krisztian9913/elderCare/adatgyujtes/meresek/meres1_uveg_doles/dataAccelX.png

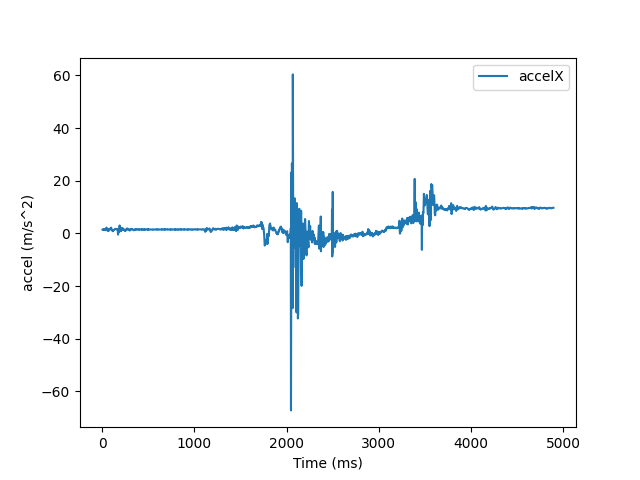
adatgyujtes/meresek/meres1_uveg_doles/dataAccelX.png
