krisztian9913/elderCare/adatgyujtes/meresek/meres1_uveg_doles/dataAccelY.png

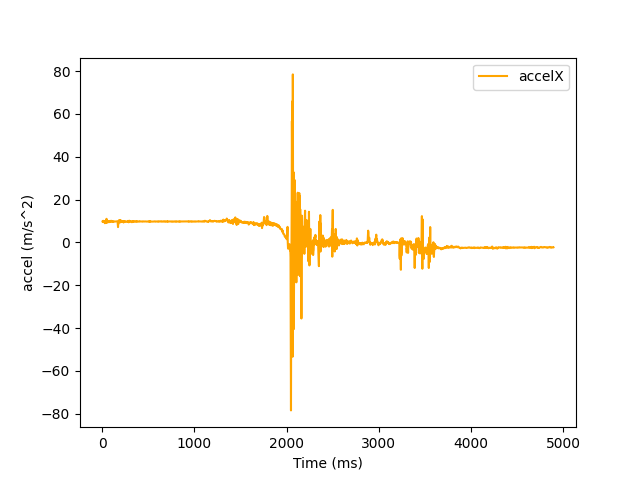
adatgyujtes/meresek/meres1_uveg_doles/dataAccelY.png
