krisztian9913/elderCare/adatgyujtes/meresek/meres1_uveg_doles/datamerged.png

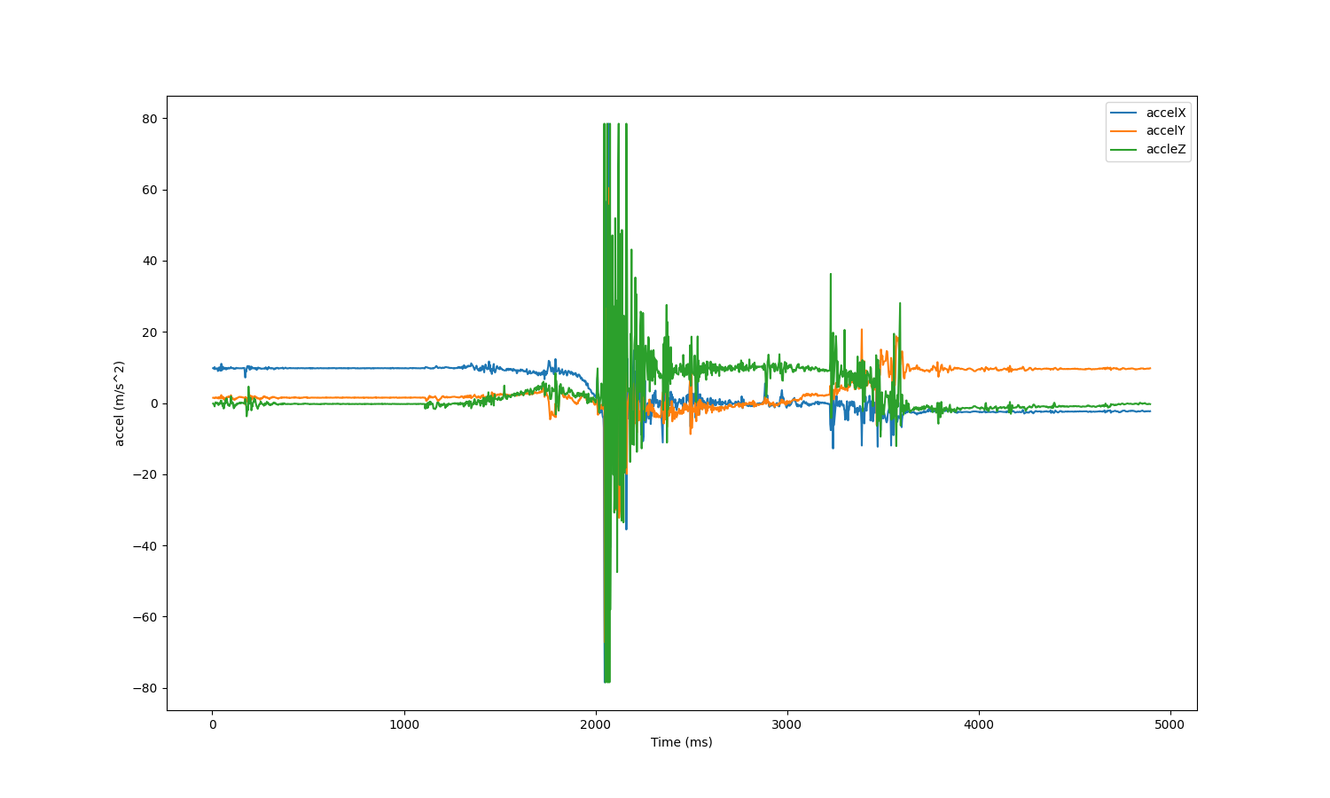
adatgyujtes/meresek/meres1_uveg_doles/datamerged.png
