krisztian9913/elderCare/adatgyujtes/meresek/meres2_allas_egyhelyben/data(7)merged.png

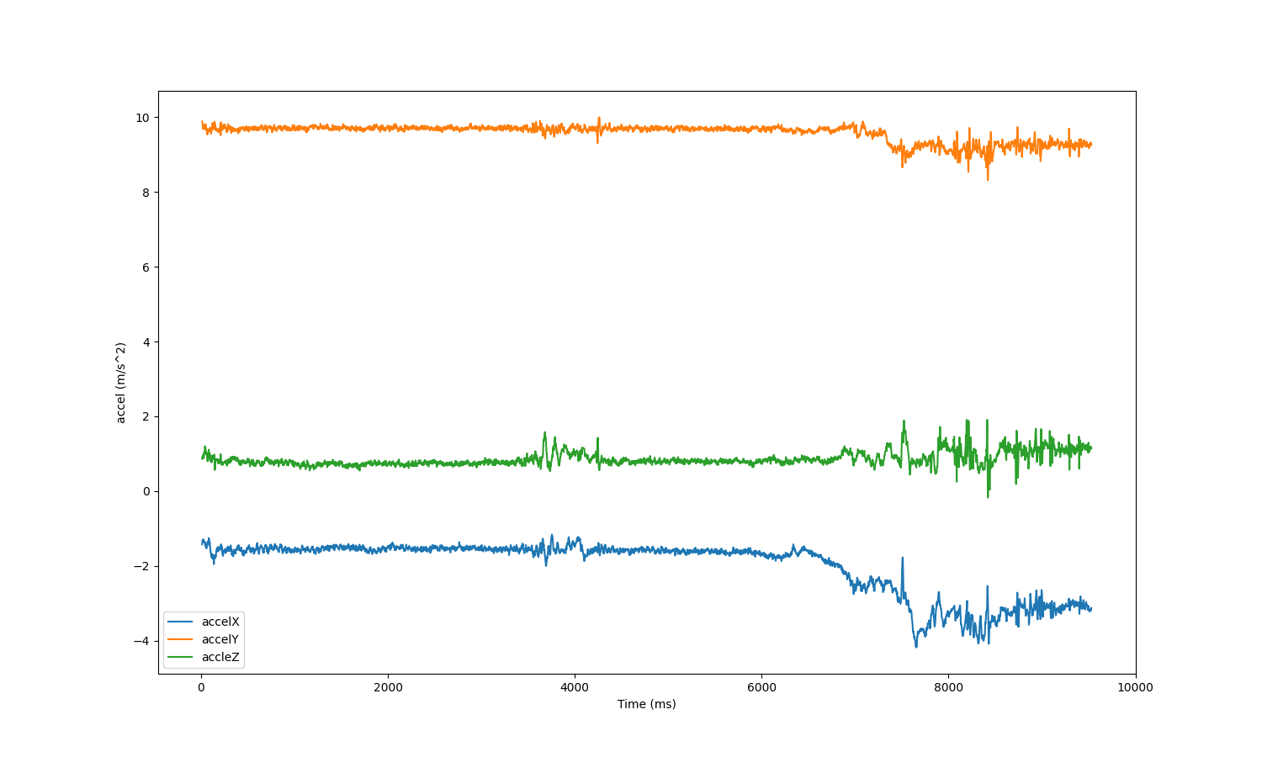
adatgyujtes/meresek/meres2_allas_egyhelyben/data(7)merged.png
