krisztian9913/elderCare/adatgyujtes/meresek/meres3_setalas/data(9)AccelX.png

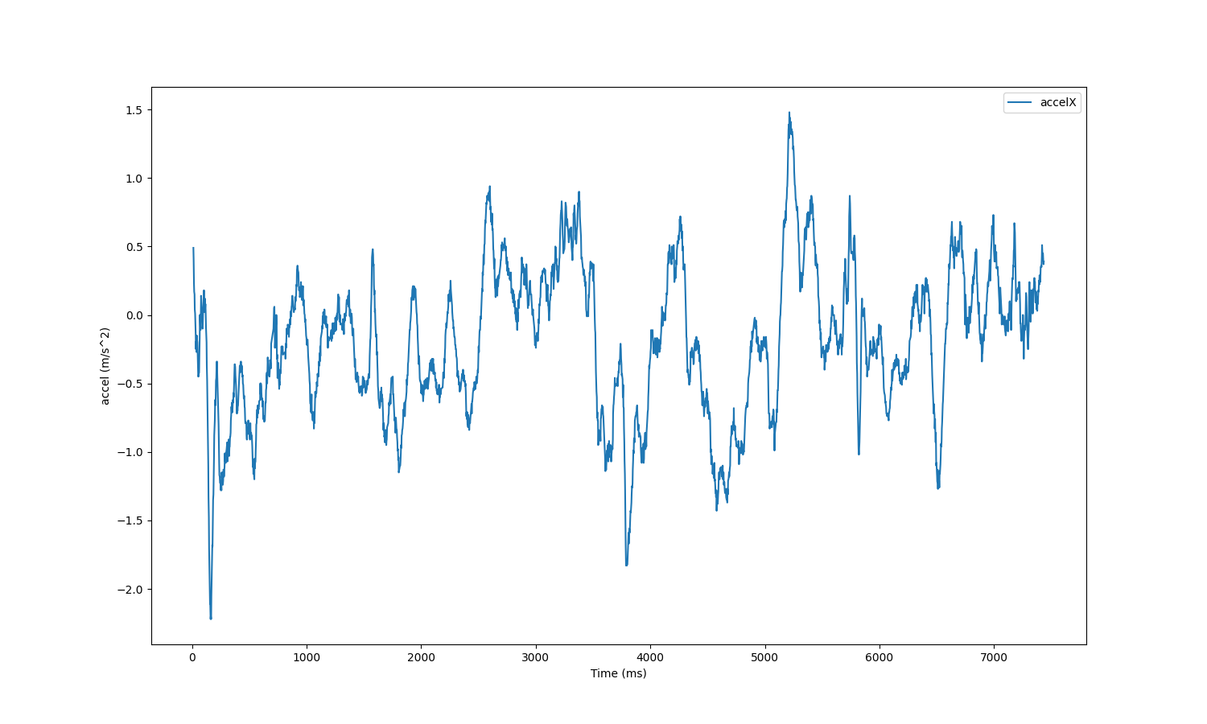
adatgyujtes/meresek/meres3_setalas/data(9)AccelX.png
