krisztian9913/elderCare/adatgyujtes/meresek/meres4_karlendites/data(10)AccelY.png

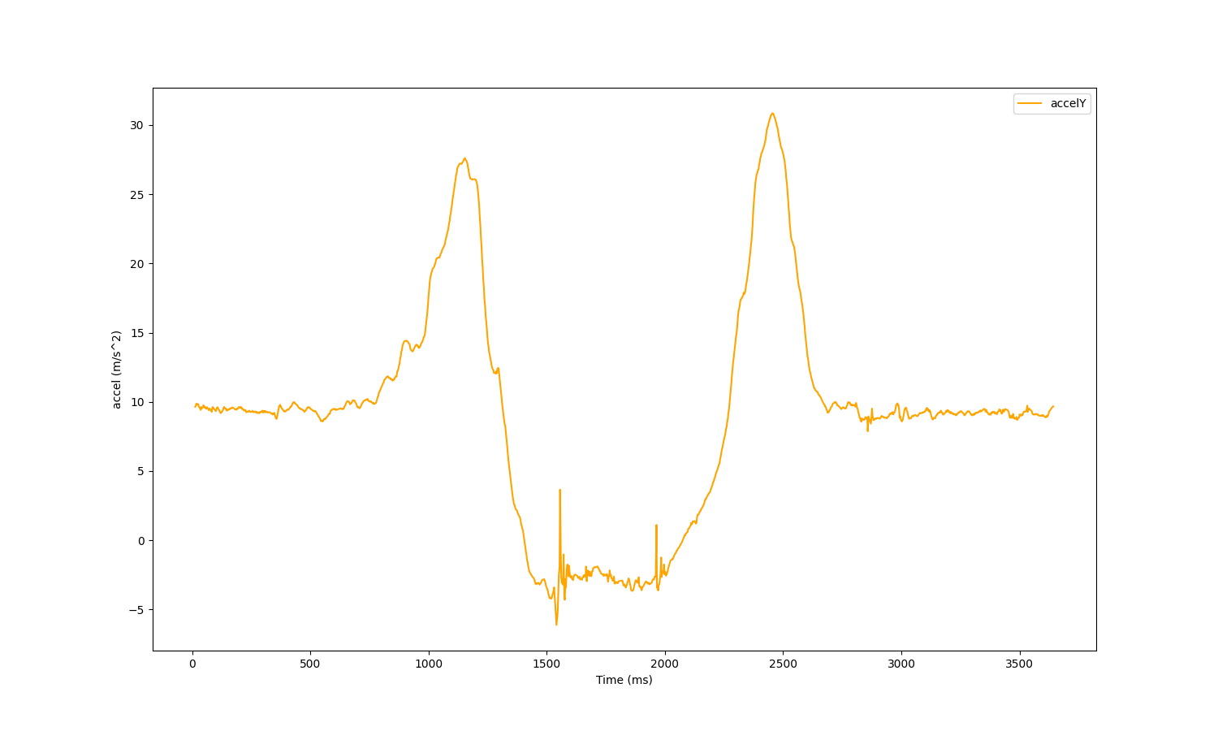
adatgyujtes/meresek/meres4_karlendites/data(10)AccelY.png
