krisztian9913/elderCare/adatgyujtes/meresek/meres4_karlendites/data(10)AccelZ.png

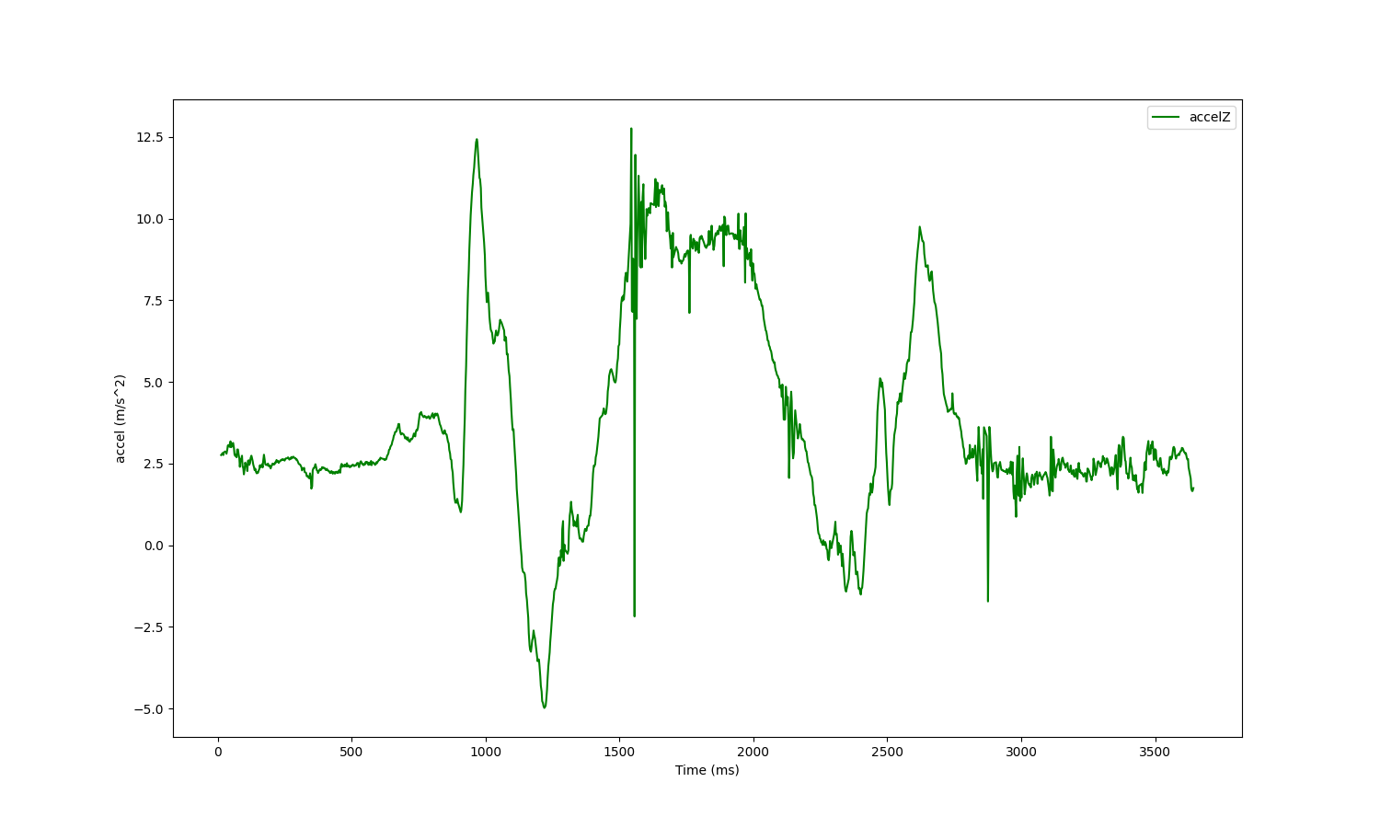
adatgyujtes/meresek/meres4_karlendites/data(10)AccelZ.png
