krisztian9913/elderCare/adatgyujtes/meresek/meres5_eldoles/data(11)AccelX.png

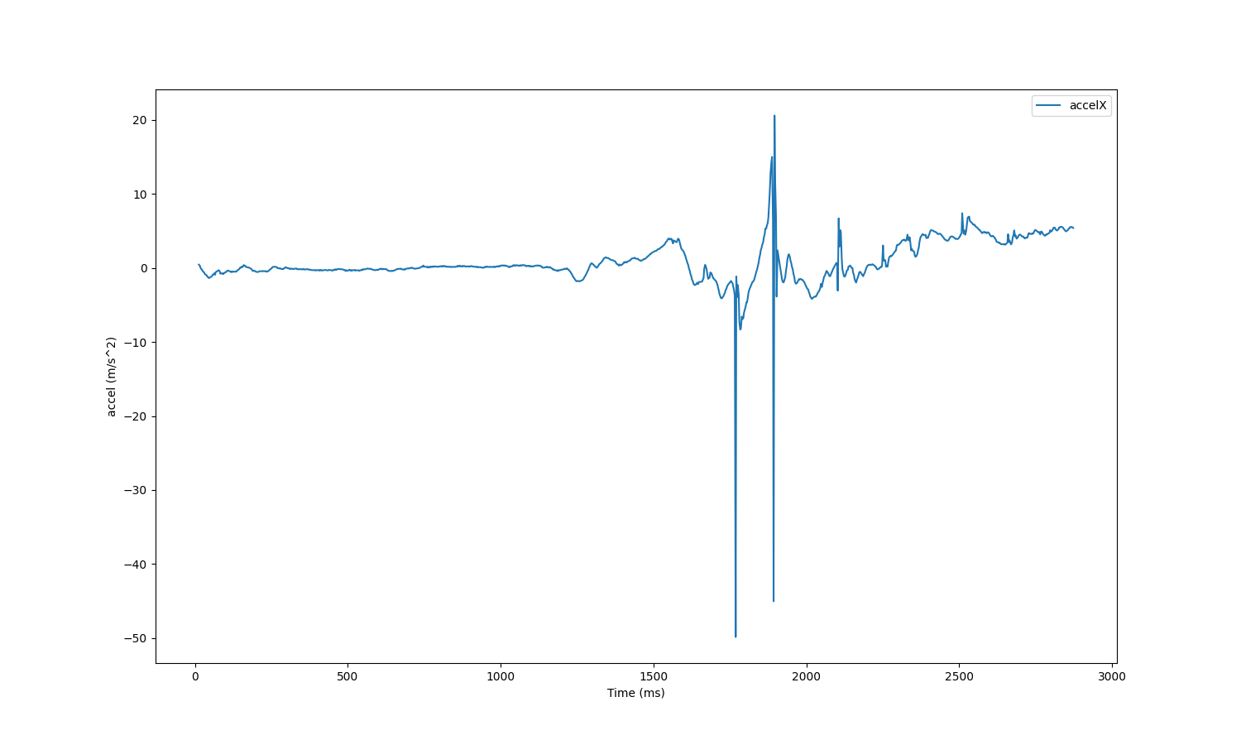
adatgyujtes/meresek/meres5_eldoles/data(11)AccelX.png
