krisztian9913/elderCare/adatgyujtes/meresek/meres5_eldoles/data(11)AccelY.png

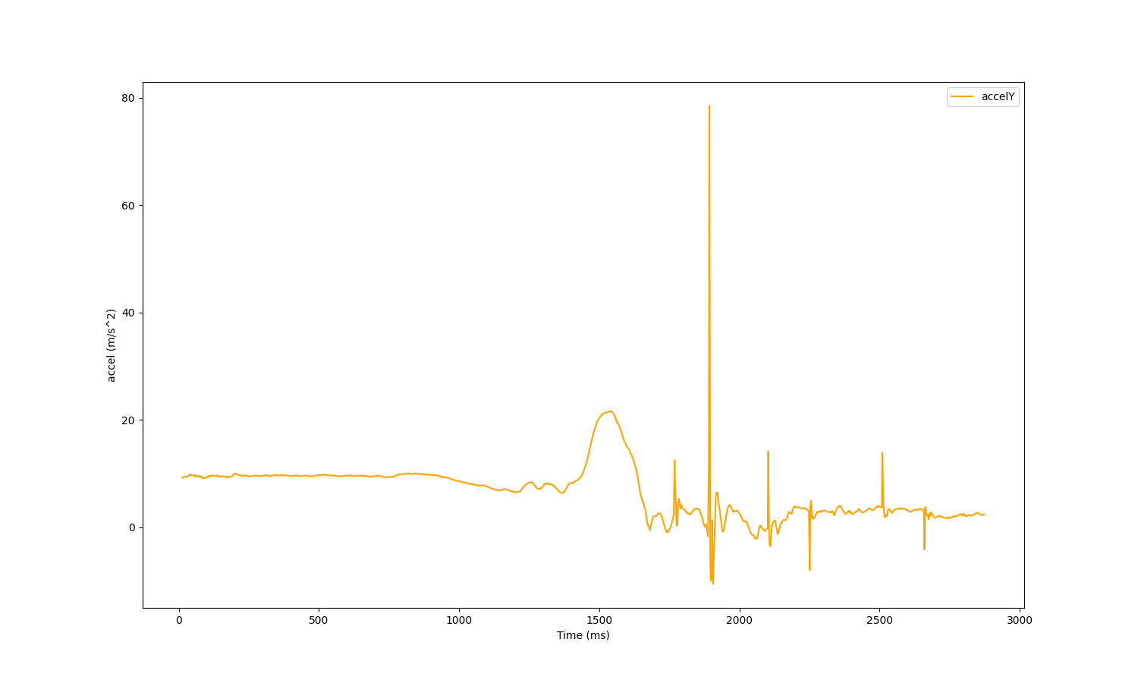
adatgyujtes/meresek/meres5_eldoles/data(11)AccelY.png
