krisztian9913/elderCare/adatgyujtes/meresek/meres5_eldoles/data(11)AccelZ.png

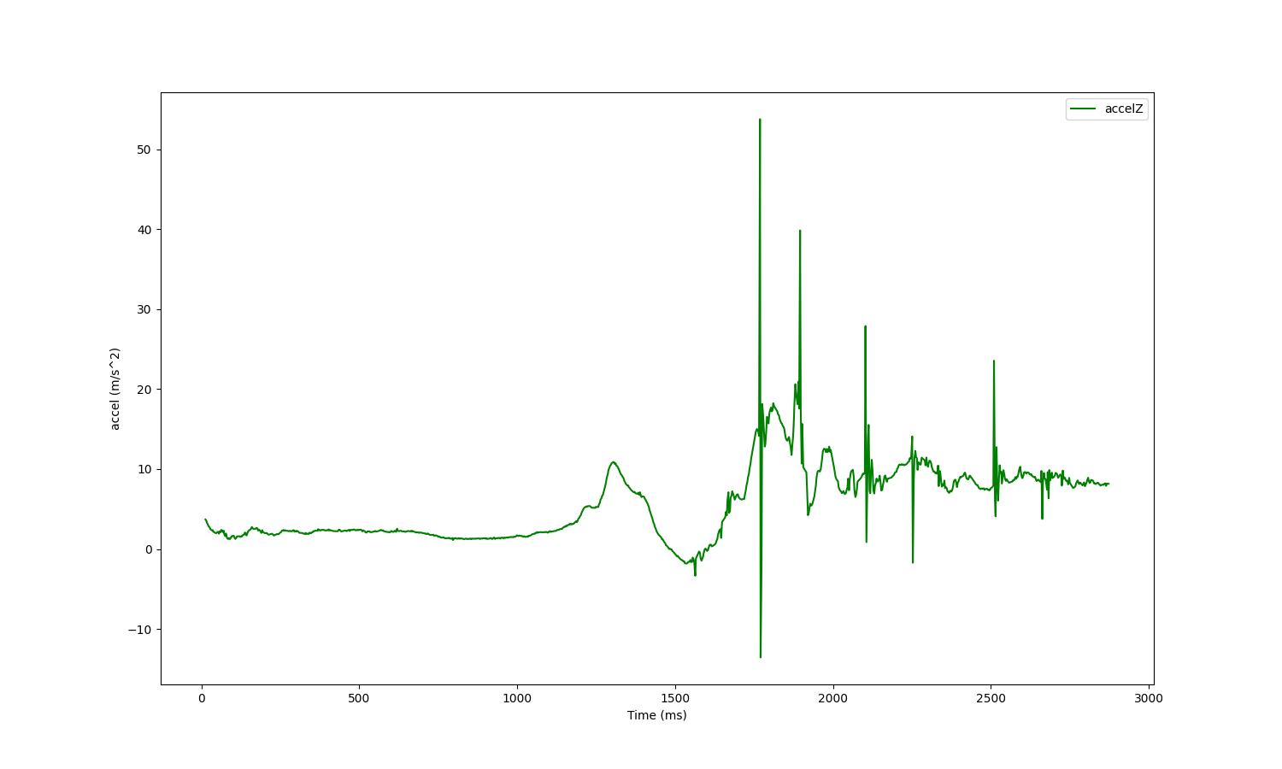
adatgyujtes/meresek/meres5_eldoles/data(11)AccelZ.png
