krisztian9913/elderCare/adatgyujtes/meresek/meres5_eldoles/data(11)merged.png

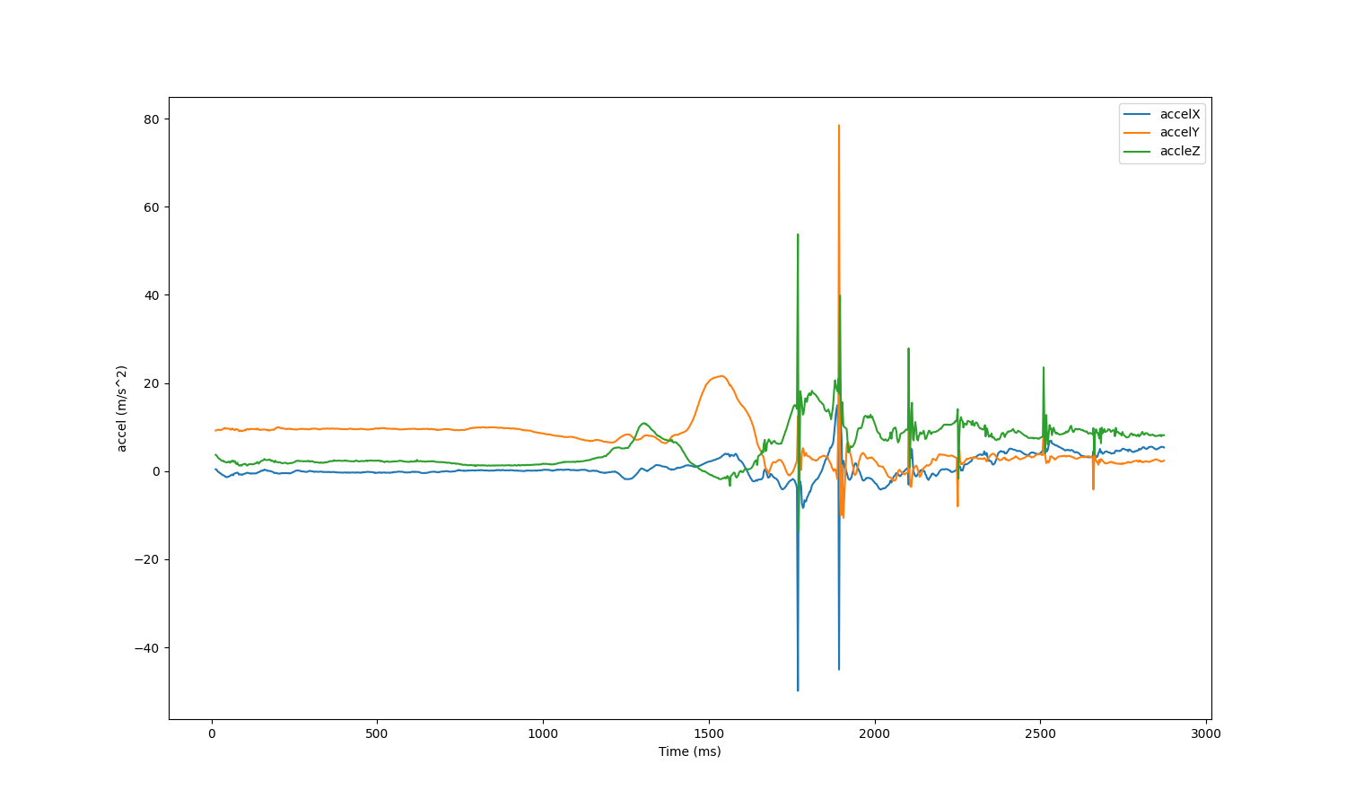
adatgyujtes/meresek/meres5_eldoles/data(11)merged.png
