krisztian9913/elderCare/adatgyujtes/meresek/meres6_leules/data(12)AccelY.png

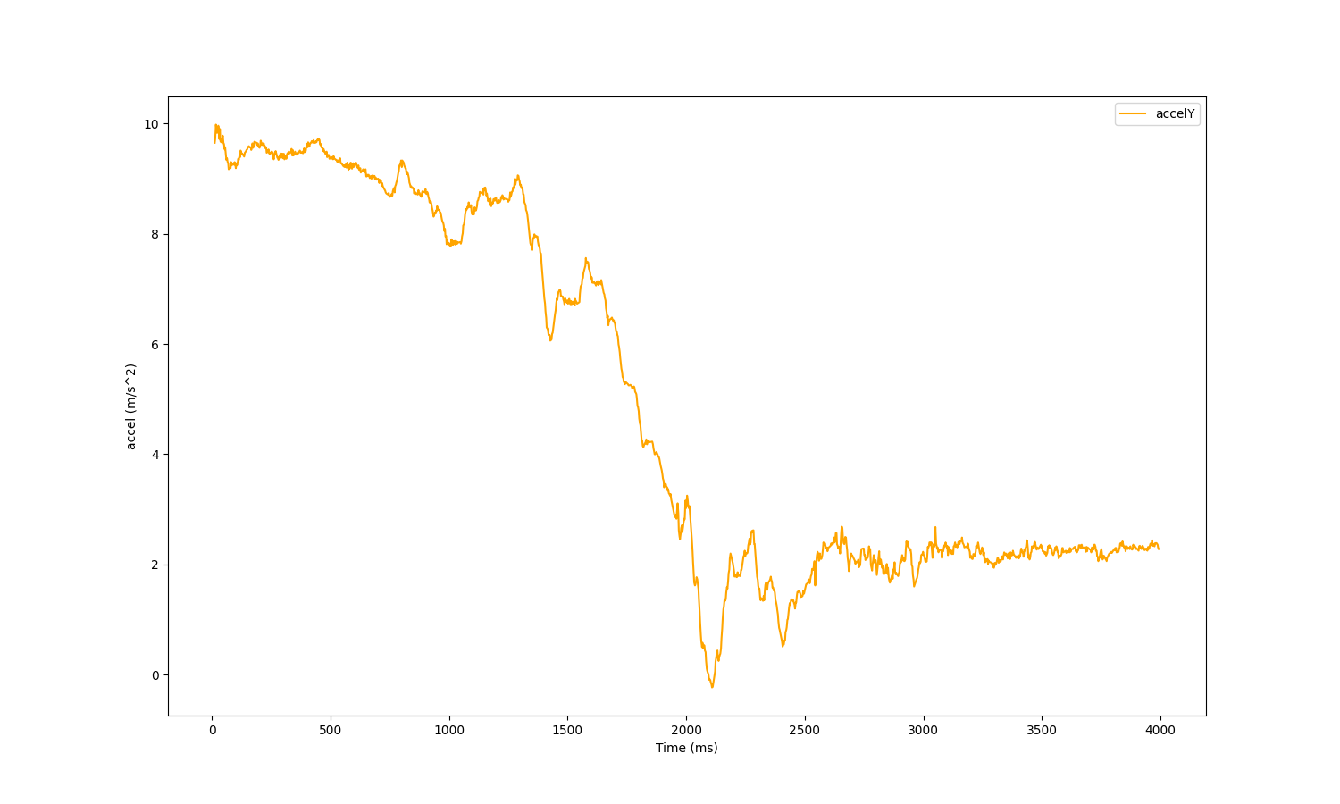
adatgyujtes/meresek/meres6_leules/data(12)AccelY.png
