krisztian9913/elderCare/adatgyujtes/meresek/meres6_leules/data(12)AccelZ.png

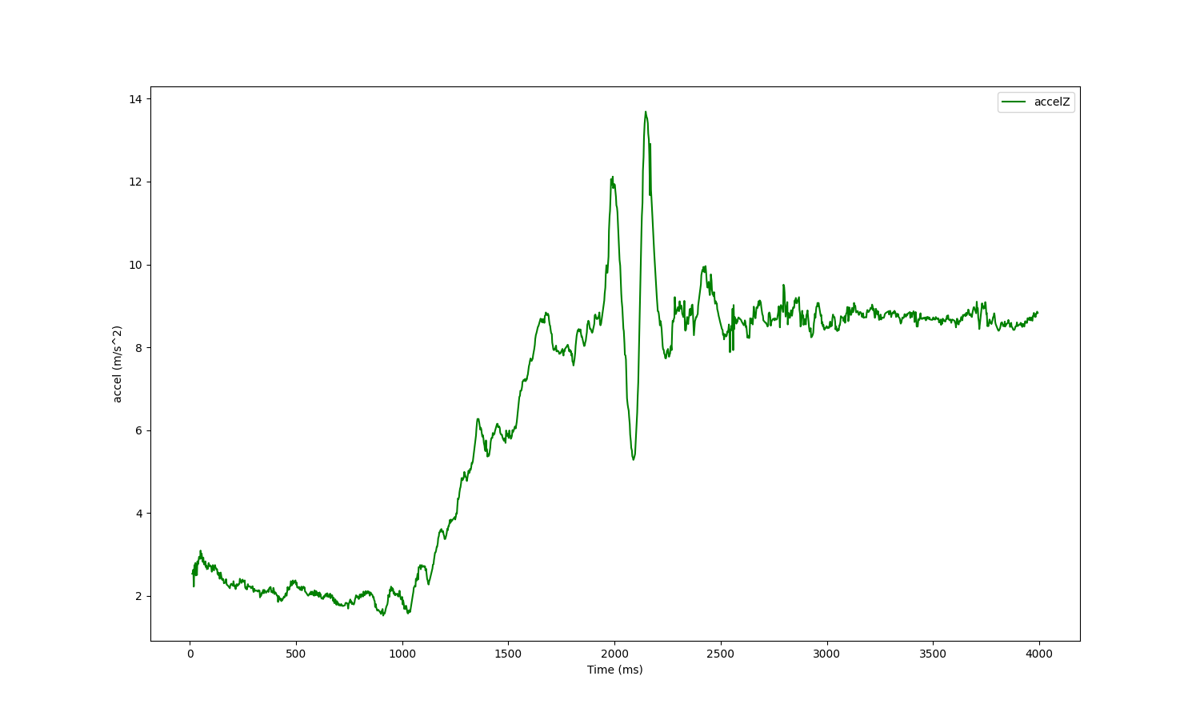
adatgyujtes/meresek/meres6_leules/data(12)AccelZ.png
