krisztian9913/elderCare/adatgyujtes/meresek/meres7_felallas/data(13)AccelZ.png

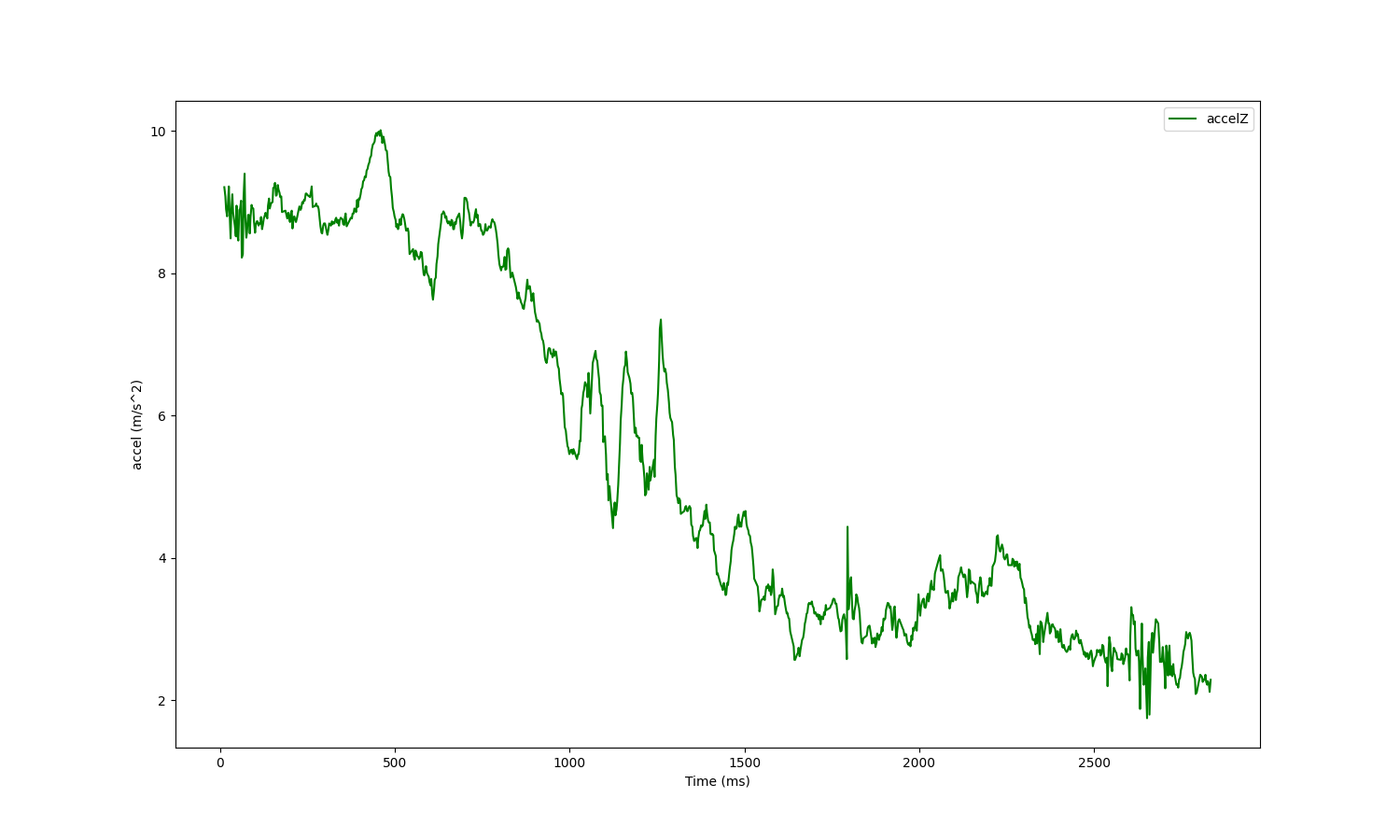
adatgyujtes/meresek/meres7_felallas/data(13)AccelZ.png
