krisztian9913/elderCare/adatgyujtes/meresek/meres8_felallas_es_leules/data(14)AccelY.png

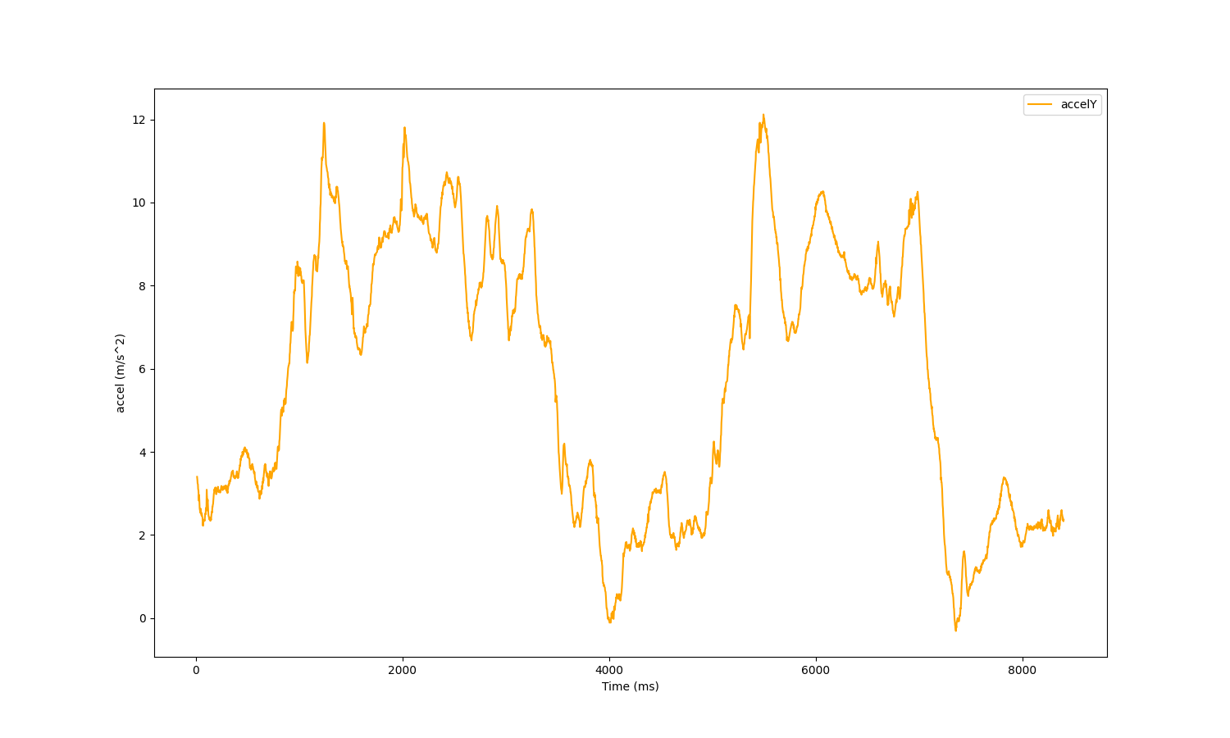
adatgyujtes/meresek/meres8_felallas_es_leules/data(14)AccelY.png
