krisztian9913/elderCare/adatgyujtes/meresek/meres9_szekbe_huppanas/data(15)AccelX.png

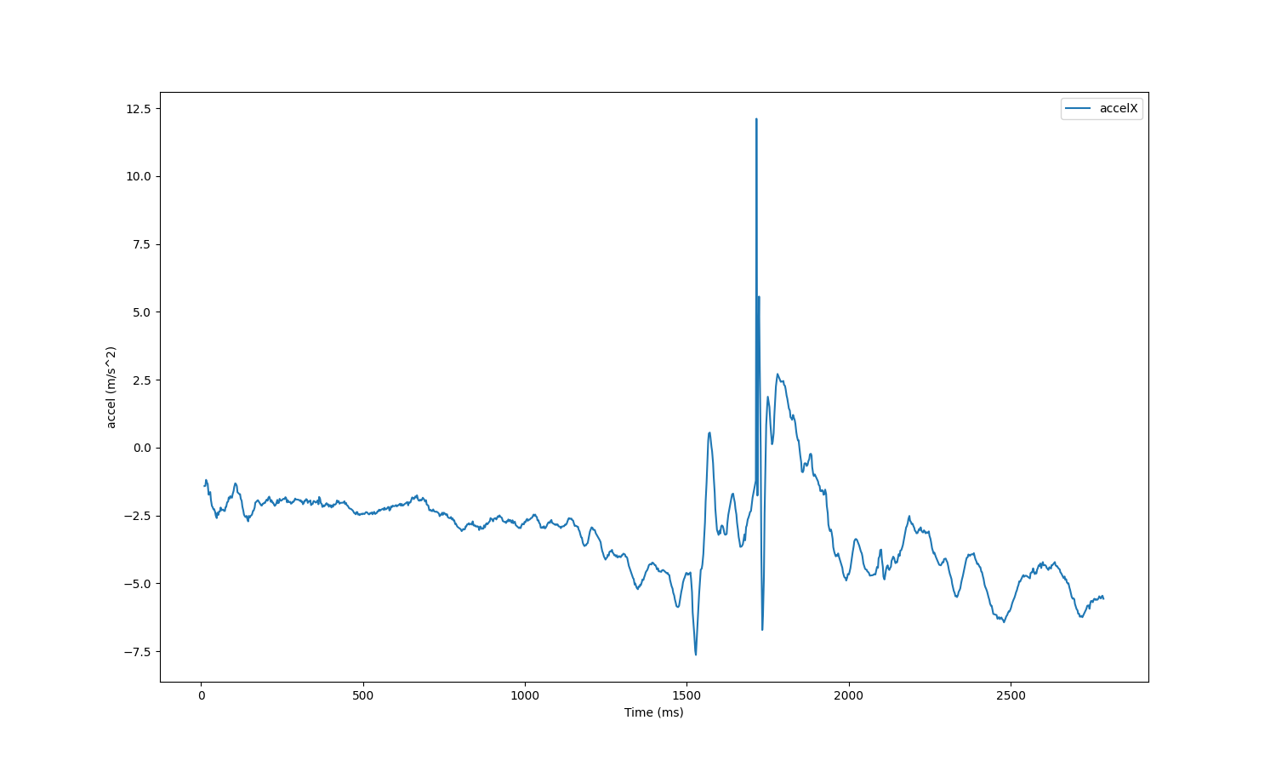
adatgyujtes/meresek/meres9_szekbe_huppanas/data(15)AccelX.png
