krisztian9913/elderCare/adatgyujtes/meresek/meres9_szekbe_huppanas/data(15)AccelZ.png

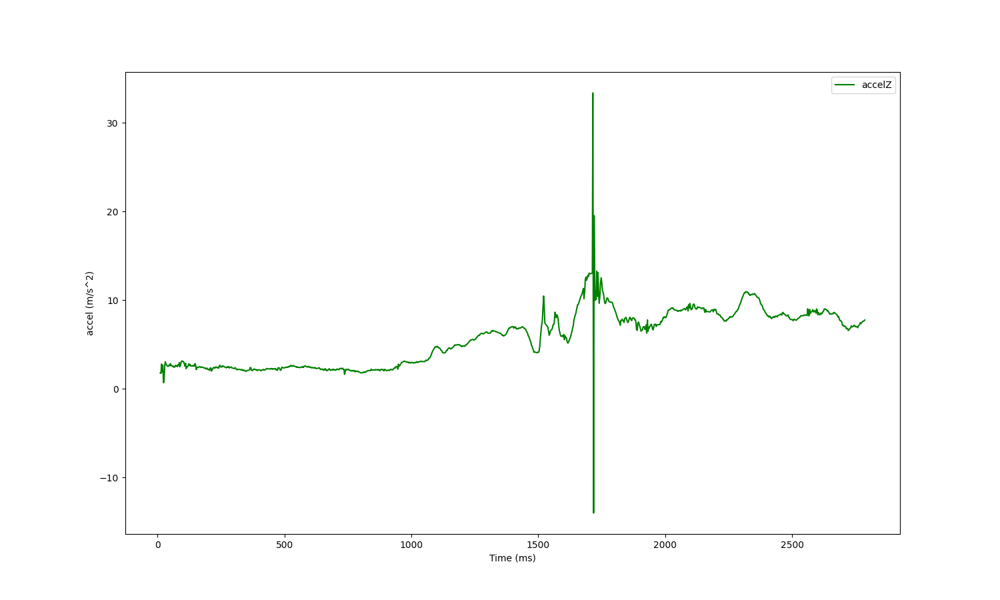
adatgyujtes/meresek/meres9_szekbe_huppanas/data(15)AccelZ.png
