krisztian9913/elderCare/adatgyujtes/meresek/meres10_bukkfenc/data(16)AccelX.png

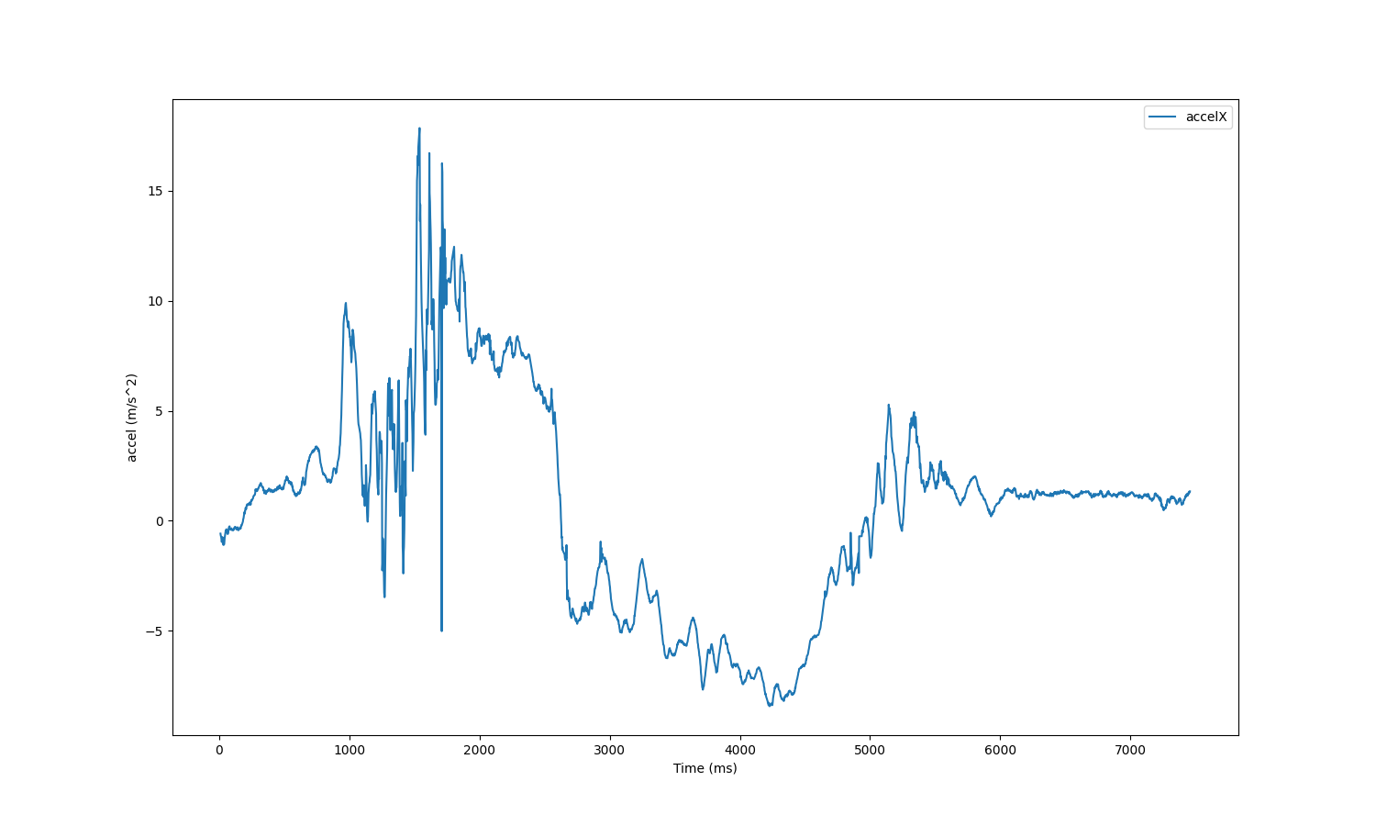
adatgyujtes/meresek/meres10_bukkfenc/data(16)AccelX.png
