krisztian9913/elderCare/adatgyujtes/meresek/meres10_bukkfenc/data(16)AccelZ.png

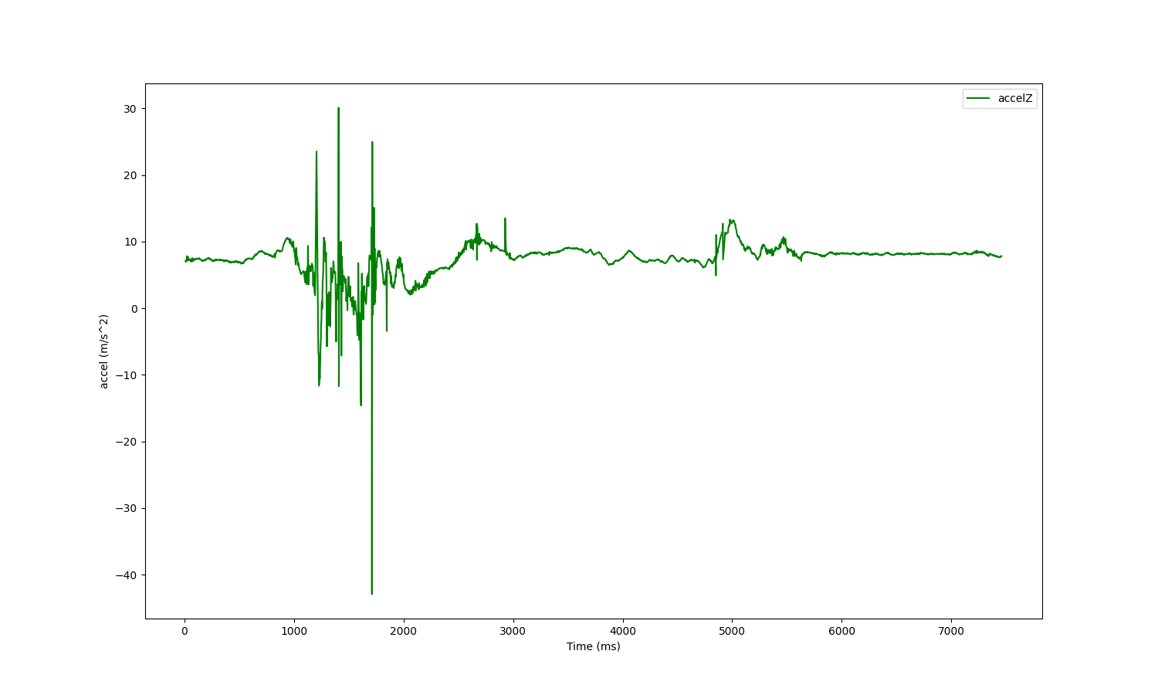
adatgyujtes/meresek/meres10_bukkfenc/data(16)AccelZ.png
