krisztian9913/elderCare/adatgyujtes/meresek/meres10_bukkfenc/data(16)merged.png

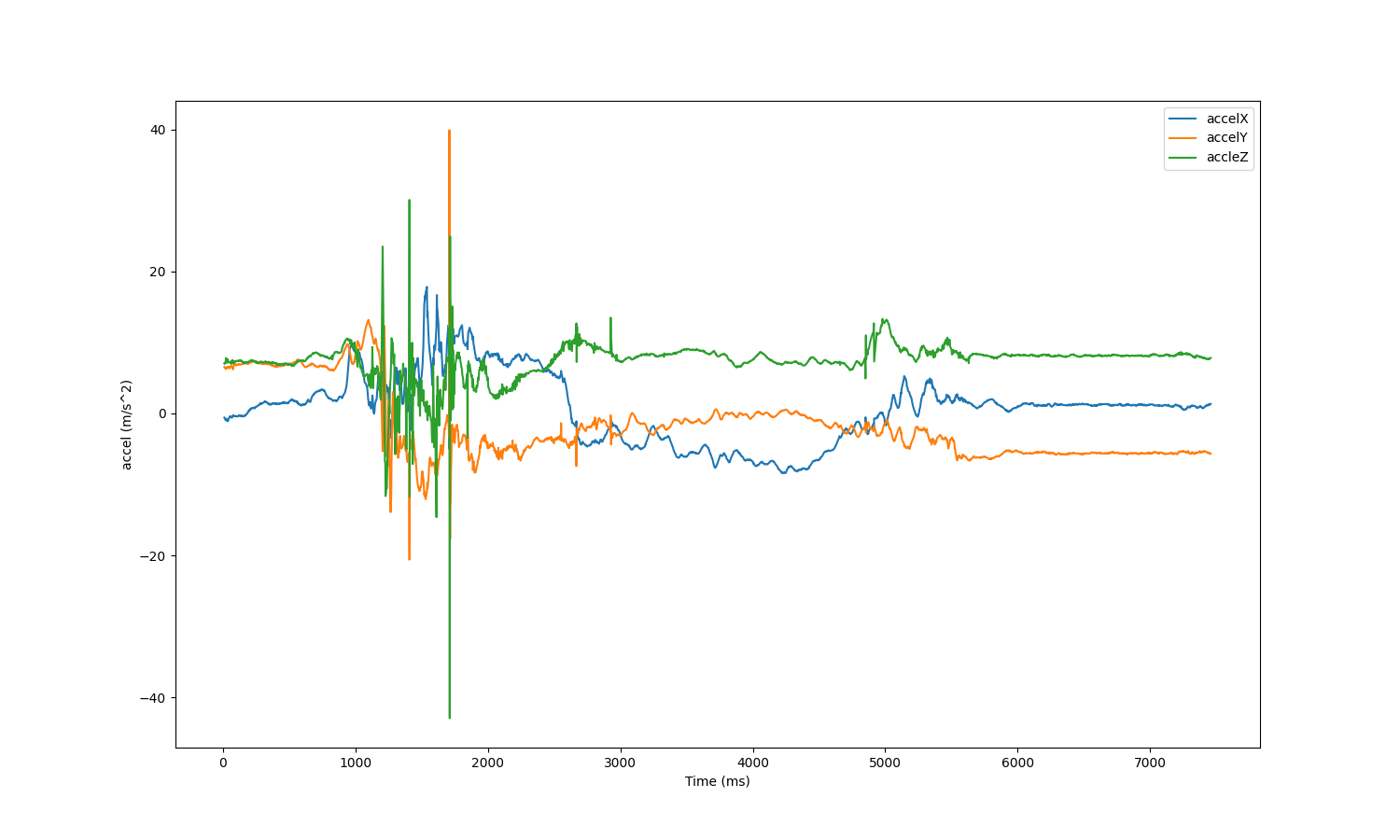
adatgyujtes/meresek/meres10_bukkfenc/data(16)merged.png
