krisztian9913/elderCare/adatgyujtes/meresek/meres11_gepeles/data(17)merged.png

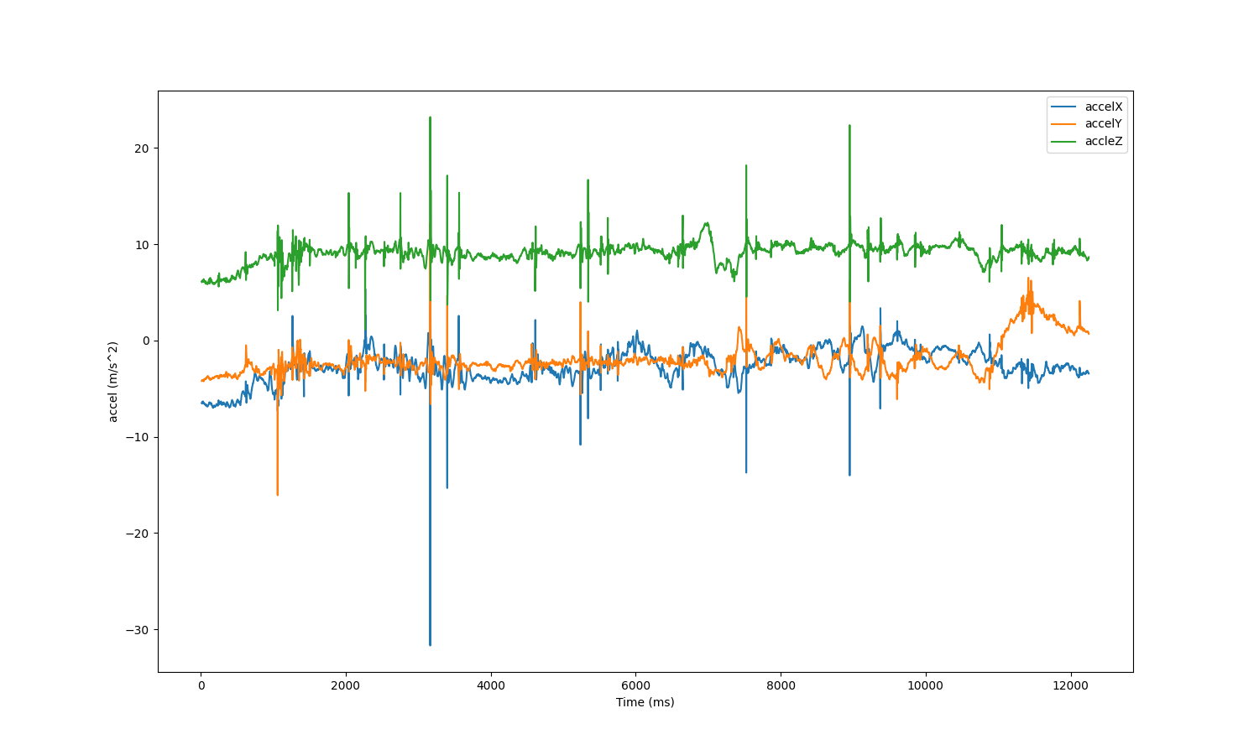
adatgyujtes/meresek/meres11_gepeles/data(17)merged.png
