krisztian9913/elderCare/nRF/mqtt_GNSS2/alvo_allapot.png

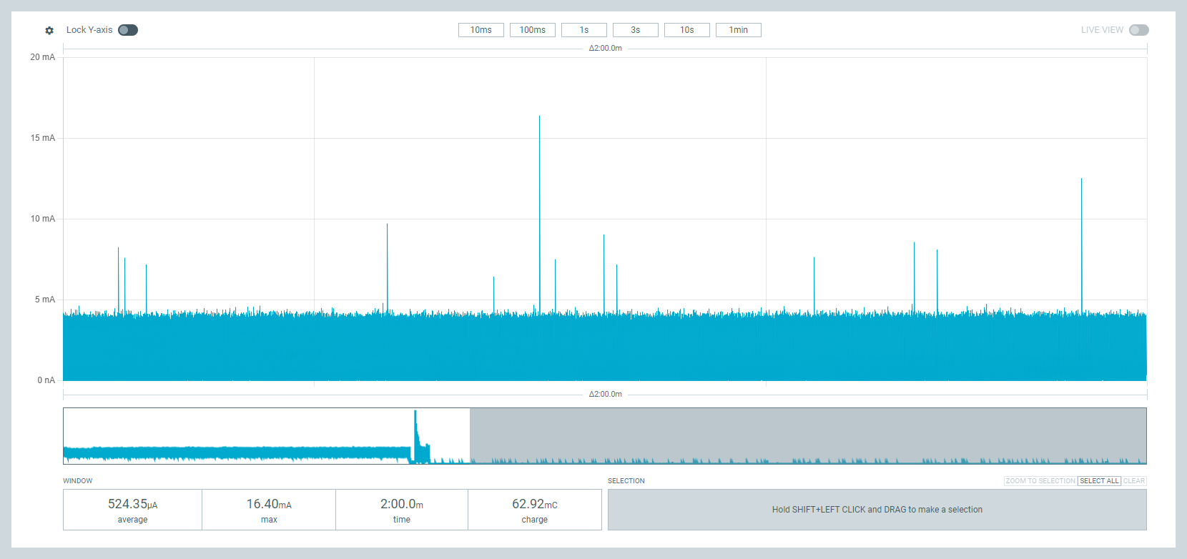
nRF/mqtt_GNSS2/alvo_allapot.png
