krisztian9913/elderCare/nRF/mqtt_GNSS2/gnss_es_mqtt_kozott.png

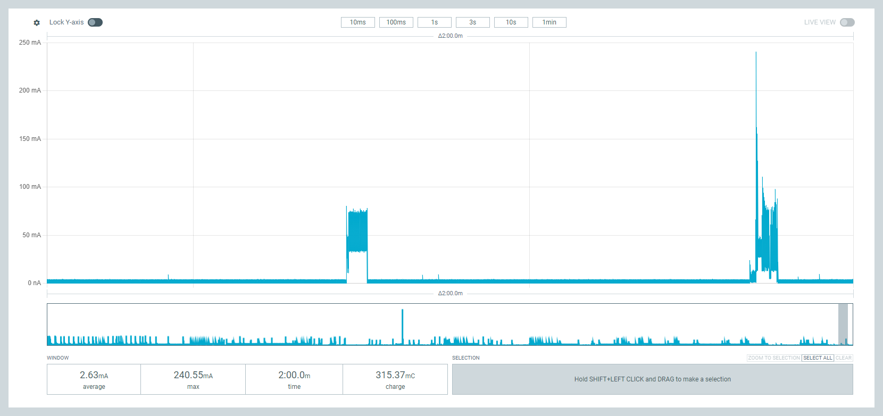
nRF/mqtt_GNSS2/gnss_es_mqtt_kozott.png
