krisztian9913/elderCare/tesztaramkor/testESP32_2/testESP32_2/3d models/waveshare-esp32-c3-zero-1.snapshot.6/Waveshare ESP32-C3 Zero.step

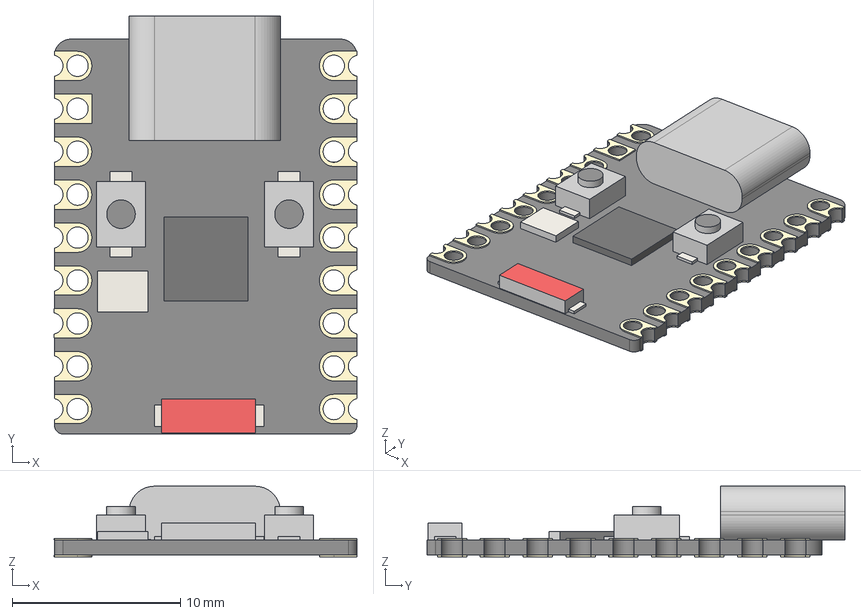
[picture p53: CAD file, 2025-05-13]
tesztaramkor/testESP32_2/testESP32_2/3d models/waveshare-esp32-c3-zero-1.snapshot.6/Waveshare ESP32-C3 Zero.step
18.0 x 24.9 x 4.20 mm
PCB
USB Type-C
SoC
BOOT
RESET
Crystal
Antenna
