krisztian9913/elderCare/tesztaramkor/testESP32_2/testESP32_2/testESP32_2 v4.step

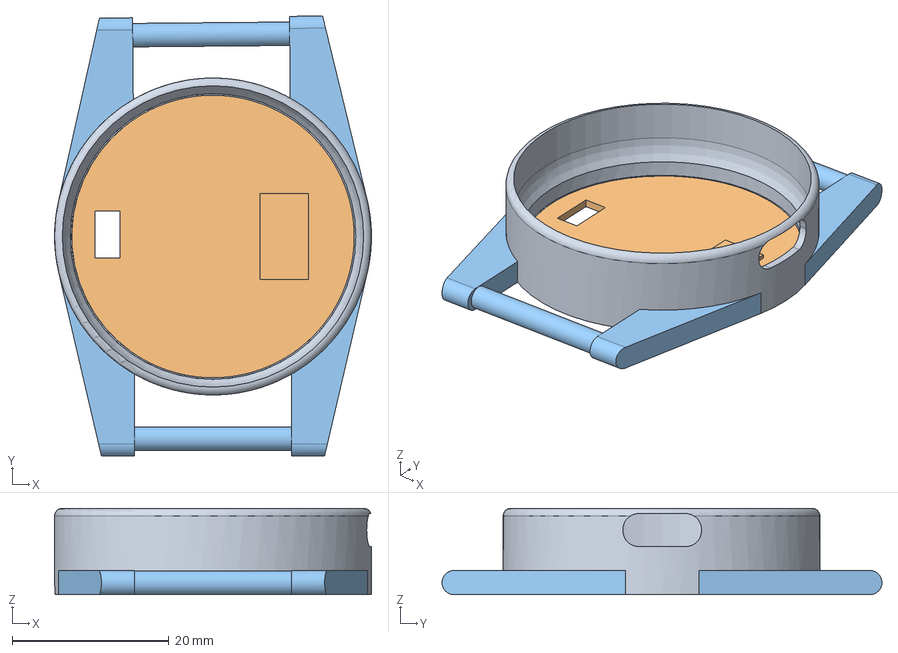
[picture p54: CAD file, 2025-05-13]
tesztaramkor/testESP32_2/testESP32_2/testESP32_2 v4.step
40.4 x 56.1 x 11.0 mm
