krisztian9913/elderCare/tesztaramkor/testESP32_2/testESP32_2/Waveshare ESP32-C3 Zero_header v1.step

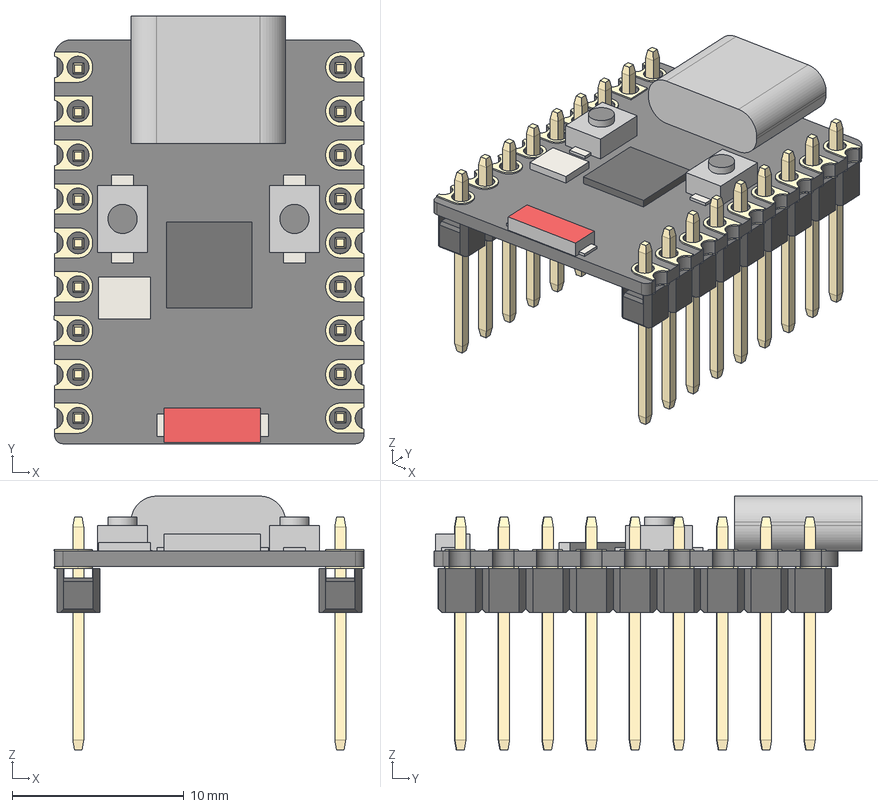
[picture p56: CAD file, 2025-05-13]
tesztaramkor/testESP32_2/testESP32_2/Waveshare ESP32-C3 Zero_header v1.step
18.0 x 24.9 x 14.8 mm
PCB
USB Type-C
SoC
BOOT
RESET
Crystal
Antenna
