krisztian9913/elderCare/tesztaramkor/testESP32_2/testESP32_2/3d models/single-row-male-pin-headers-1.snapshot.3/1x4 Male Pin Header.STEP

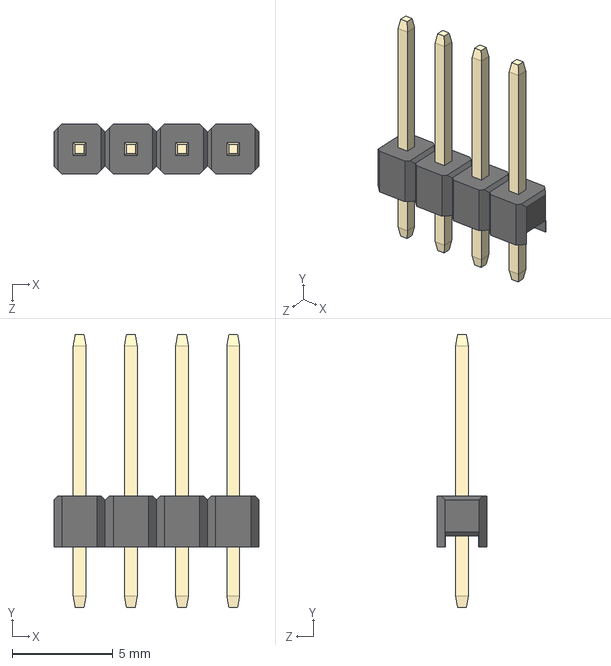
[picture p58: CAD file, 2025-05-13]
tesztaramkor/testESP32_2/testESP32_2/3d models/single-row-male-pin-headers-1.snapshot.3/1x4 Male Pin Header.STEP
10.2 x 13.5 x 2.50 mm
