krisztian9913/elderCare/tesztaramkor/testESP32_2/testESP32_2/3d models/single-row-male-pin-headers-1.snapshot.3/1x15 Male Pin Header Angle.STEP

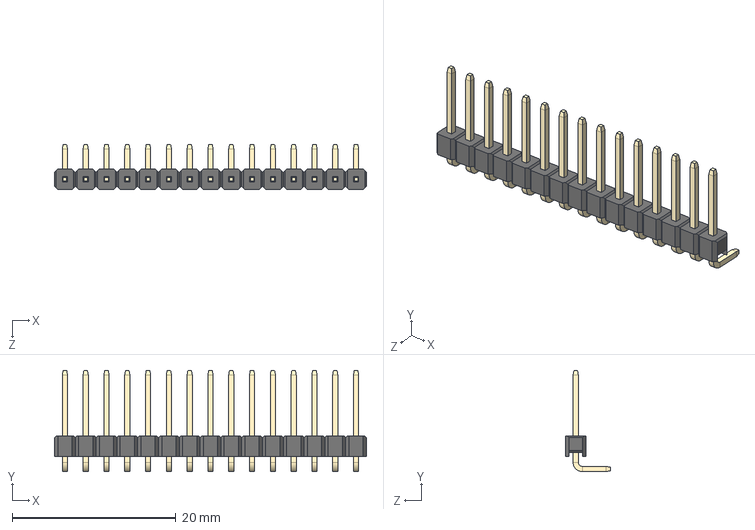
[picture p67: CAD file, 2025-05-13]
tesztaramkor/testESP32_2/testESP32_2/3d models/single-row-male-pin-headers-1.snapshot.3/1x15 Male Pin Header Angle.STEP
38.1 x 12.4 x 5.50 mm
