krisztian9913/elderCare/(list of files, cad)

Other CAD files:
tesztaramkor/testESP32_2/testESP32_2/3d models/MAX30102 v2.step
tesztaramkor/testESP32_2/testESP32_2/3d models/waveshare-esp32-c3-zero-1.snapshot.6/Waveshare ESP32-C3 Zero.f3d
tesztaramkor/testESP32_2/testESP32_2/testESP32_2 v4.stl
