krisztian9913/elderCare/tesztaramkor/testESP32_2/testESP32_2/testESP32_2.kicad_pcb

## KiCad design tesztaramkor/testESP32_2/testESP32_2/testESP32_2.kicad_pcb (2025-05-13)

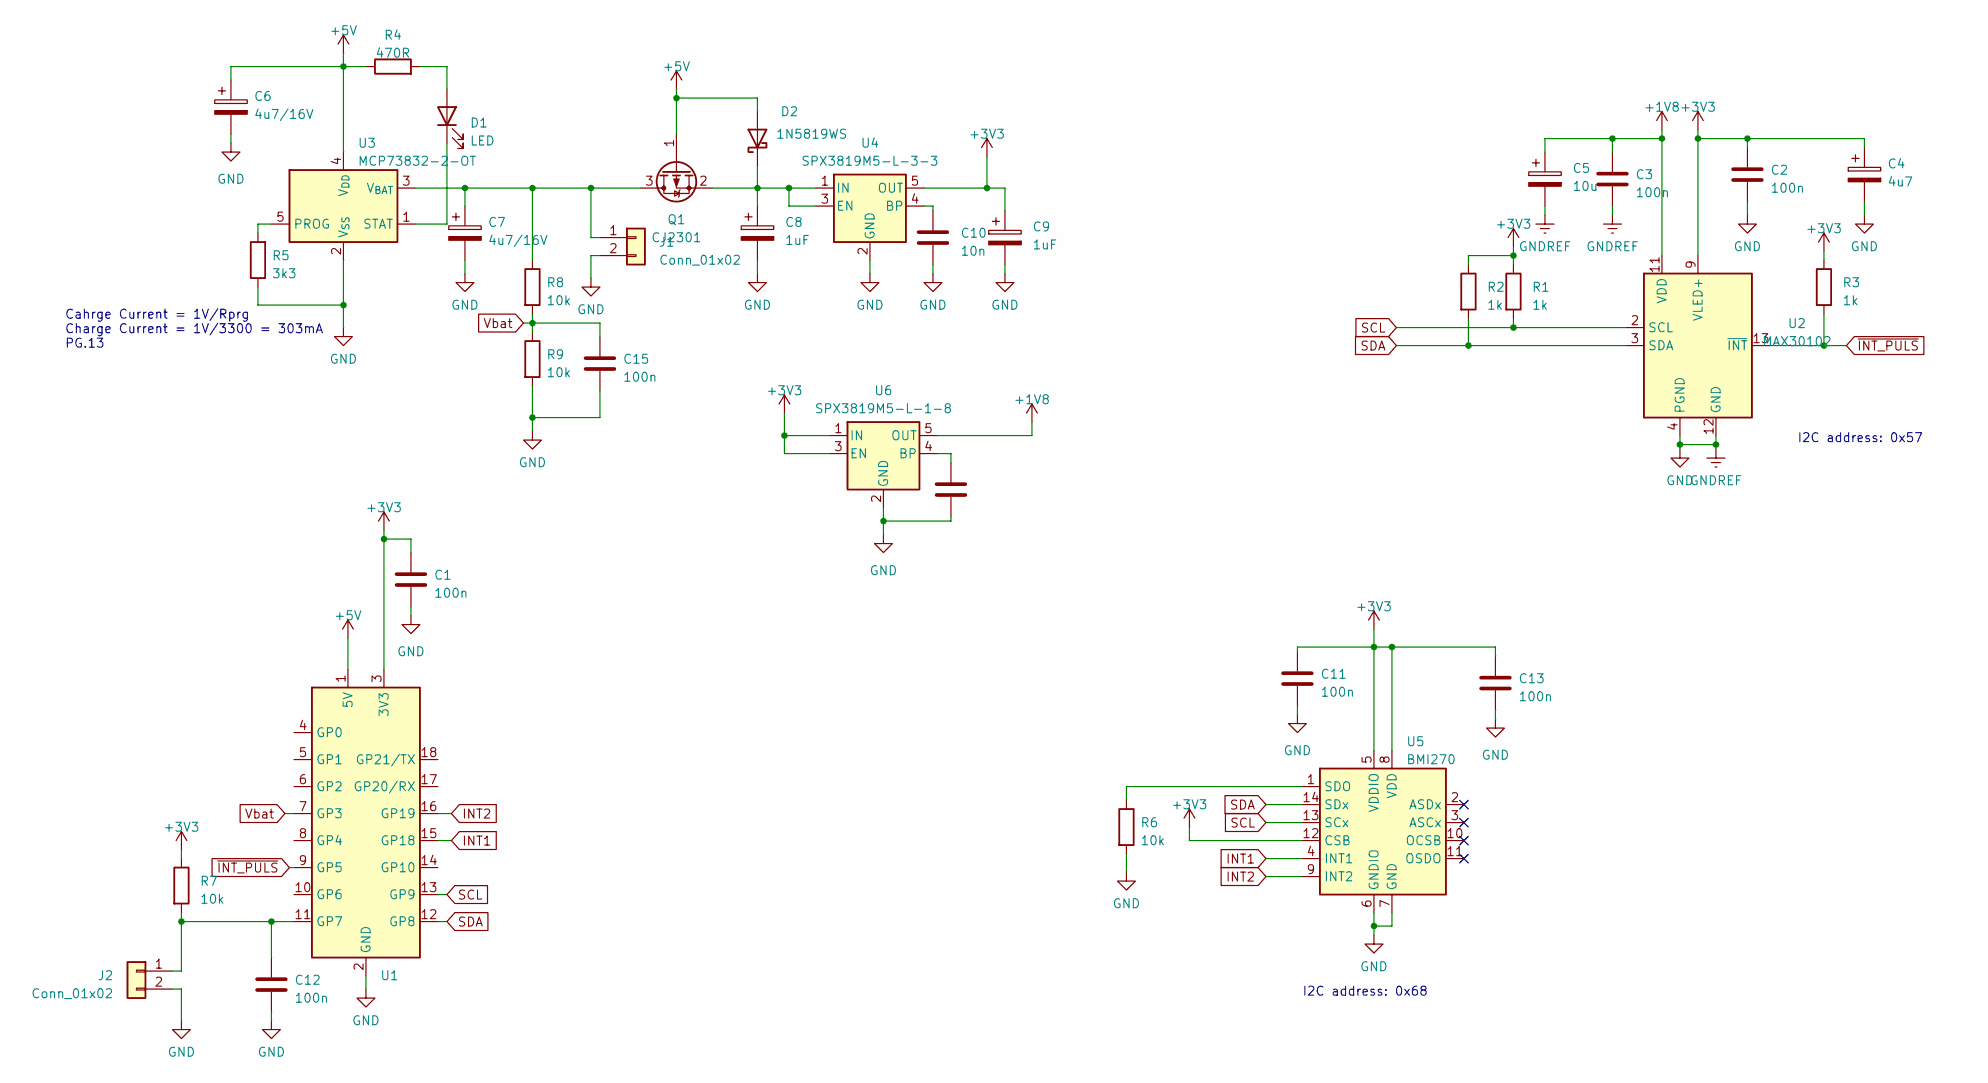
[picture p79: schematic testESP32_2.kicad_sch]

Parts:
C1, C2, C3, C11, C12, C13, C15: 100n; C_0603_1608Metric_Pad1.08x0.95mm_HandSolder
C4: 4u7; CP_EIA-3216-18_Kemet-A_Pad1.58x1.35mm_HandSolder
C5: 10u; CP_EIA-3216-18_Kemet-A_Pad1.58x1.35mm_HandSolder
C6, C7: 4u7/16V; CP_EIA-3216-10_Kemet-I_Pad1.58x1.35mm_HandSolder
C8, C9: 1uF; CP_EIA-3216-10_Kemet-I_Pad1.58x1.35mm_HandSolder
C10, C14: 10n; C_0603_1608Metric_Pad1.08x0.95mm_HandSolder
D1: LED; LED_0603_1608Metric_Pad1.05x0.95mm_HandSolder
D2: 1N5819WS; D_SOD-323_HandSoldering
J1, J2: Conn_01x02; PinHeader_1x02_P2.54mm_Vertical
Q1: CJ2301; SOT-23
R1, R2, R3: 1k; R_0603_1608Metric_Pad0.98x0.95mm_HandSolder
R4: 470R; R_0603_1608Metric_Pad0.98x0.95mm_HandSolder
R5: 3k3; R_0603_1608Metric_Pad0.98x0.95mm_HandSolder
R6, R7, R8, R9: 10k; R_0603_1608Metric_Pad0.98x0.95mm_HandSolder
U1: ESP32-C3-Zero
U2: MAX30102; Maxim_OLGA-14_3.3x5.6mm_P0.8mm
U3: MCP73832-2-OT; SOT-23-5
U4: SPX3819M5-L-3-3; SOT-23-5
U5: BMI270; Bosch_LGA-14_3x2.5mm_P0.5mm
U6: SPX3819M5-L-1-8; SOT-23-5

Connections:
+1V8: C3.1, C5.1, U2.11 (VDD), U6.5 (OUT)
+3V3: C1.1, C2.1, C4.1, C9.1, C11.1, C13.1, R1.1, R2.1, R3.1, R7.1, U1.3 (3V3), U2.9 (VLED+), U2.10 (VLED+), U4.5 (OUT), U5.5 (VDDIO), U5.8 (VDD), U5.12 (CSB), U6.1 (IN), U6.3 (EN)
+5V: C6.1, D2.2 (A), Q1.1 (G), R4.1, U1.1 (5V), U3.4 (V_{DD})
GND: C1.2, C2.2, C3.2, C4.2, C5.2, C6.2, C7.2, C8.2, C9.2, C10.2, C11.2, C12.2, C13.2, C14.2, C15.2, J1.2, J2.2, R5.1, R6.2, R9.2, U1.2 (GND), U2.4 (PGND), U2.12 (GND), U3.2 (V_{SS}), U4.2 (GND), U5.6 (GNDIO), U5.7 (GND), U6.2 (GND)
INT1: U1.15 (GP18), U5.4 (INT1)
INT2: U1.16 (GP19), U5.9 (INT2)
unnamed: D1.2 (A), R4.2
unnamed: D1.1 (K), U3.1 (STAT)
unnamed: C8.1, D2.1 (K), Q1.2 (S), U4.1 (IN), U4.3 (EN)
unnamed: C7.1, J1.1, Q1.3 (D), R8.1, U3.3 (V_{BAT})
unnamed: C12.1, J2.1, R7.2, U1.11 (GP7)
unnamed: R5.2, U3.5 (PROG)
unnamed: C10.1, U4.4 (BP)
unnamed: R6.1, U5.1 (SDO)
unnamed: C14.1, U6.4 (BP)
SCL: R1.2, U1.13 (GP9), U2.2 (SCL), U5.13 (SCx)
SDA: R2.2, U1.12 (GP8), U2.3 (SDA), U5.14 (SDx)
Vbat: C15.1, R8.2, R9.1, U1.7 (GP3)
~INT_PULS: R3.2, U1.9 (GP5), U2.13 (~INT)

Notes on the sheet:
Cahrge Current = 1V/Rprg Charge Current = 1V/3300 = 303mA PG.13
I2C address: 0x57
I2C address: 0x68

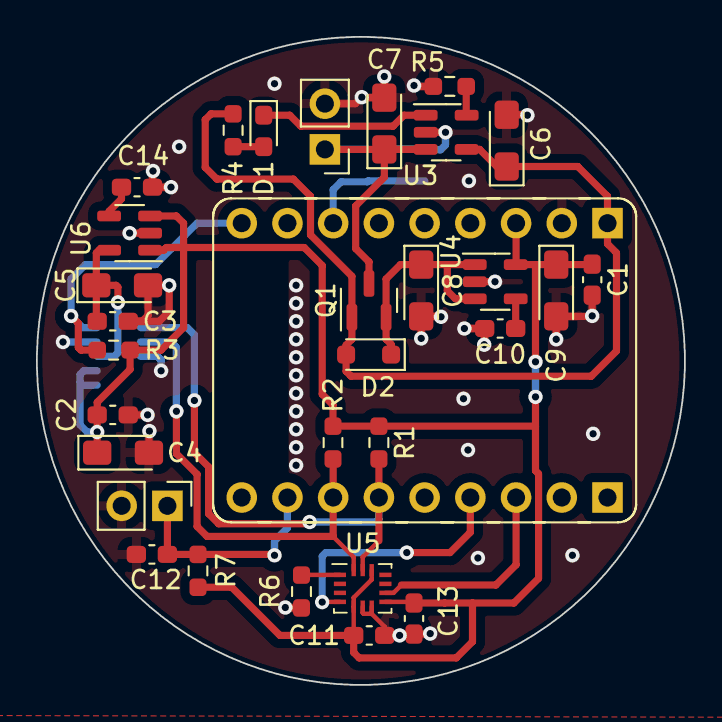
[picture p80: board testESP32_2.kicad_pcb from above]

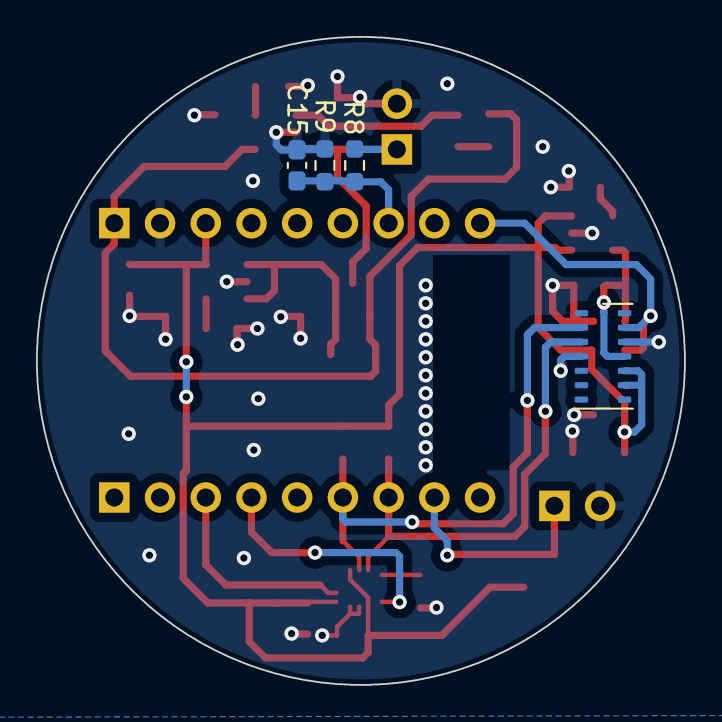
[picture p81: board testESP32_2.kicad_pcb from below]

Board: 2 copper layers, 36.0 x 36.0 mm, 35 parts (4 on the bottom side), 19 nets.
