krisztian9913/elderCare/adatgyujtes/python/usbReceiver/accelerationMagnitude.py

import numpy as np
import pandas as pd
import matplotlib.pyplot as plt
import math

fileCsv = "data(16).csv"

def readCSV(fileName):
    data = pd.read_csv(fileName, header=None)

    print(len(data))

    print(data[2:-1])

    return data[2:-1]

def plotDatas(data):

    D = data.to_numpy()

    D = D.astype(float)

    print(len(D))


    t = D[:, 0]
    ax = D[:, 1]
    ay = D[:, 2]
    az = D[:, 3]

    magnitude = calculateMagnitude(ax, ay, az) #gyorsulas nagysaga


    plt.figure(figsize=(15, 9))

    plt.subplot(1, 2, 1)

    plt.plot(t, ax)
    plt.plot(t, ay)
    plt.plot(t, az)

    plt.legend(["accelX", "accelY", "accleZ"])
    plt.ylabel("accel (m/s^2)")
    plt.xlabel("Time (ms)")

    #plt.xlim([1900, 2400])

    #plt.show()

    plt.subplot(1, 2, 2)
    plt.plot(t, magnitude, "red")
    plt.legend(["magnitude"])
    #plt.ylabel(" Acceleration (g)")
    plt.xlabel("Time (ms)")

    plt.show()

def calculateMagnitude(ax, ay, az):

    axSquare = ax ** 2
    aySquare = ay ** 2
    azSauqre = az ** 2

    sum = axSquare + aySquare + azSauqre

    print(sum)

    magnitude = np.sqrt(sum)

    print(magnitude)

    return magnitude

if __name__ == "__main__":

    data = readCSV(fileCsv)
    #print(data)
    plotDatas(data)
