krisztian9913/elderCare/adatgyujtes/ESP-NOW/ESP-NOW_sender/src/BMI270.cpp

#include "BMI270.h"

extern TwoWire I2C;

uint8_t bmi270_config_file[] = {
    0xc8, 0x2e, 0x00, 0x2e, 0x80, 0x2e, 0x3d, 0xb1, 0xc8, 0x2e, 0x00, 0x2e, 0x80, 0x2e, 0x91, 0x03, 0x80, 0x2e, 0xbc,
    0xb0, 0x80, 0x2e, 0xa3, 0x03, 0xc8, 0x2e, 0x00, 0x2e, 0x80, 0x2e, 0x00, 0xb0, 0x50, 0x30, 0x21, 0x2e, 0x59, 0xf5,
    0x10, 0x30, 0x21, 0x2e, 0x6a, 0xf5, 0x80, 0x2e, 0x3b, 0x03, 0x00, 0x00, 0x00, 0x00, 0x08, 0x19, 0x01, 0x00, 0x22,
    0x00, 0x75, 0x00, 0x00, 0x10, 0x00, 0x10, 0xd1, 0x00, 0xb3, 0x43, 0x80, 0x2e, 0x00, 0xc1, 0x80, 0x2e, 0x00, 0xc1,
    0x80, 0x2e, 0x00, 0xc1, 0x80, 0x2e, 0x00, 0xc1, 0x80, 0x2e, 0x00, 0xc1, 0x80, 0x2e, 0x00, 0xc1, 0x80, 0x2e, 0x00,
    0xc1, 0x80, 0x2e, 0x00, 0xc1, 0x80, 0x2e, 0x00, 0xc1, 0x80, 0x2e, 0x00, 0xc1, 0x80, 0x2e, 0x00, 0xc1, 0x80, 0x2e,
    0x00, 0xc1, 0x80, 0x2e, 0x00, 0xc1, 0x80, 0x2e, 0x00, 0xc1, 0x80, 0x2e, 0x00, 0xc1, 0x80, 0x2e, 0x00, 0xc1, 0x80,
    0x2e, 0x00, 0xc1, 0x80, 0x2e, 0x00, 0xc1, 0x80, 0x2e, 0x00, 0xc1, 0x80, 0x2e, 0x00, 0xc1, 0x80, 0x2e, 0x00, 0xc1,
    0x80, 0x2e, 0x00, 0xc1, 0x80, 0x2e, 0x00, 0xc1, 0x80, 0x2e, 0x00, 0xc1, 0x80, 0x2e, 0x00, 0xc1, 0x80, 0x2e, 0x00,
    0xc1, 0x80, 0x2e, 0x00, 0xc1, 0x80, 0x2e, 0x00, 0xc1, 0x80, 0x2e, 0x00, 0xc1, 0x80, 0x2e, 0x00, 0xc1, 0x80, 0x2e,
    0x00, 0xc1, 0x80, 0x2e, 0x00, 0xc1, 0x80, 0x2e, 0x00, 0xc1, 0x80, 0x2e, 0x00, 0xc1, 0x80, 0x2e, 0x00, 0xc1, 0x80,
    0x2e, 0x00, 0xc1, 0x80, 0x2e, 0x00, 0xc1, 0x80, 0x2e, 0x00, 0xc1, 0x80, 0x2e, 0x00, 0xc1, 0x80, 0x2e, 0x00, 0xc1,
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
    }

    for(index = balByte; index < configSize; index += 2)
    {
        uploadFile((configFile + index), index, readWriteLen);
    }

    writeRegister(BMI270_ADDRESS, INIT_CTRL, 0x01);

    writeRegister(BMI270_ADDRESS, PWR_CONF, 0x01);

    return true;
}

bool checkInitialization(void)
{
    uint8_t initStatus;

    readRegister(BMI270_ADDRESS, INTERNAL_STATUS, initStatus);

    if(((initStatus >> 0u) & 1u) == 1u)
    {
        return true;
    }

    return false;
}

void setLowPowerMode(uint8_t *buffer)
{
    writeRegister(BMI270_ADDRESS, PWR_CTRL, 0x04);
    writeRegister(BMI270_ADDRESS, ACC_CONF, 0x17);
    writeRegister(BMI270_ADDRESS, PWR_CONF, 0x03);

    readRegisters(BMI270_ADDRESS, DATA_8, buffer, 6);
}

void uploadFile(uint8_t *configData, uint16_t index, uint16_t writeLen)
{
    uint8_t addrArray[2] = {0};

    addrArray[0] = (uint8_t)((index / 2) & 0x0F);

    addrArray[1] = (uint8_t)((index / 2) >> 4);

    writeRegisters(BMI270_ADDRESS, INIT_ADDR_0, addrArray, 2);
    writeRegisters(BMI270_ADDRESS, INIT_DATA, configData, writeLen);
}

void setLowPowerACCMeasure(void)
{
    uint8_t rslt;

    readRegister(BMI270_ADDRESS, PWR_CTRL, rslt);

    rslt |= (1u << 2u);
    writeRegister(BMI270_ADDRESS, PWR_CTRL, rslt);

    readRegister(BMI270_ADDRESS, ACC_CONF, rslt);

    rslt &= ~(1u << 7u); //Power optimized mode, 100 Hz
    //rslt |= (0x06 << 0u); //25Hz
    writeRegister(BMI270_ADDRESS, ACC_CONF, rslt);

    readRegister(BMI270_ADDRESS, PWR_CONF, rslt);

    rslt |= (1u << 0u);
    writeRegister(BMI270_ADDRESS, PWR_CONF, rslt);

    readRegister(BMI270_ADDRESS, INT_MAP_DATA, rslt);

    rslt |= (1u << 2u);
    writeRegister(BMI270_ADDRESS, INT_MAP_DATA, rslt);

    readRegister(BMI270_ADDRESS, INT1_IO_CTRL, rslt);

    rslt |= (1u << 1u) | (1u << 3u); //Output level active High, Output enabled, Ouput push pull mode
    writeRegister(BMI270_ADDRESS, INT1_IO_CTRL, rslt);

    

}

uint8_t readInterrupt(void)
{
    uint8_t rslt;

    readRegister(BMI270_ADDRESS, INT_STATUS_1, rslt);

    return rslt;
}

void readAccelerometerData(uint8_t *buffer)
{
    readRegisters(BMI270_ADDRESS, DATA_8, buffer, 6);
}
